Jajaho/LiPo-Board/src/kicad-2019/LiPo-BoardV1-2019.kicad_pcb

## KiCad design src/kicad-2019/LiPo-BoardV1-2019.kicad_pcb (2026-10-23)

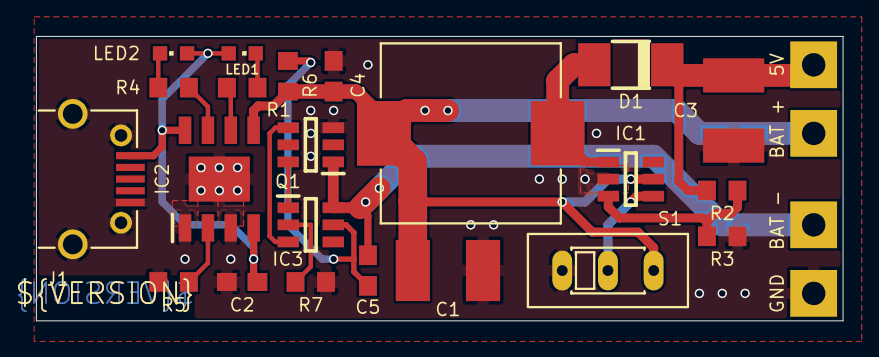
[picture p1: board LiPo-BoardV1-2019.kicad_pcb from above]

Board: 2 copper layers, 44.8 x 15.8 mm, 26 parts (0 on the bottom side), 17 nets.

Parts:
C1, C3: 22uF; C1812
C2, C4: 10uF; C0603
C5: 100n; C0603
D1: SS34; DO-214AC
IC1: MT3608; SOT-23-6
IC2: TP4056; SOP-8
IC3: FS312F-G; SOT-23-6
J1: MICRO_USB; MICROUSB
J2: 5V; CON-PAD
J3: GND; CON-PAD
J4: BAT +; CON-PAD
J5: BAT -; CON-PAD
L1: SLO1040H220MTT; INDUCTOR10.8X10
LED1: GREEN; CHIPLED_0603
LED2: RED; CHIPLED_0603
Q1: FS8205; SOT-23-6
R1, R3, R4, R7: 1k; R0603
R2: 7k5; R0603
R5: 1k2; R0603
R6: 100R; R0603
S1: SPDT

Connections:
5V: C3.1, D1.C, J2.1, R2.2
BAT+: C1.1, C4.1, IC1.5, IC2.5, J4.1, L1.1, R6.1, S1.1
BAT-: C5.2, IC3.6, J5.1, Q1.1
GND: C1.2, C2.2, C3.2, C4.2, IC1.2, IC2.1, IC2.3, IC2.9, J1.5, J1.MP1, J1.MP2, J1.MP3, J1.MP4, J3.1, Q1.3, R3.1, R5.1, R7.1, S1.3
unnamed: D1.A, IC1.1, L1.2
unnamed: LED1.C, R1.2
unnamed: LED2.C, R4.2
unnamed: IC2.7, R4.1
unnamed: IC2.6, R1.1
unnamed: IC1.3, R2.1, R3.2
unnamed: IC2.2, R5.2
unnamed: IC1.4, S1.2
unnamed: IC3.1, Q1.6
unnamed: IC3.3, Q1.4
unnamed: IC3.2, R7.2
unnamed: C5.1, IC3.5, R6.2
VBUS: C2.1, IC2.4, IC2.8, J1.1, LED1.A, LED2.A
