Jajaho/LiPo-Board/src/LiPo-BoardV1.brd

## EAGLE design src/LiPo-BoardV1.brd (2023-07-04)

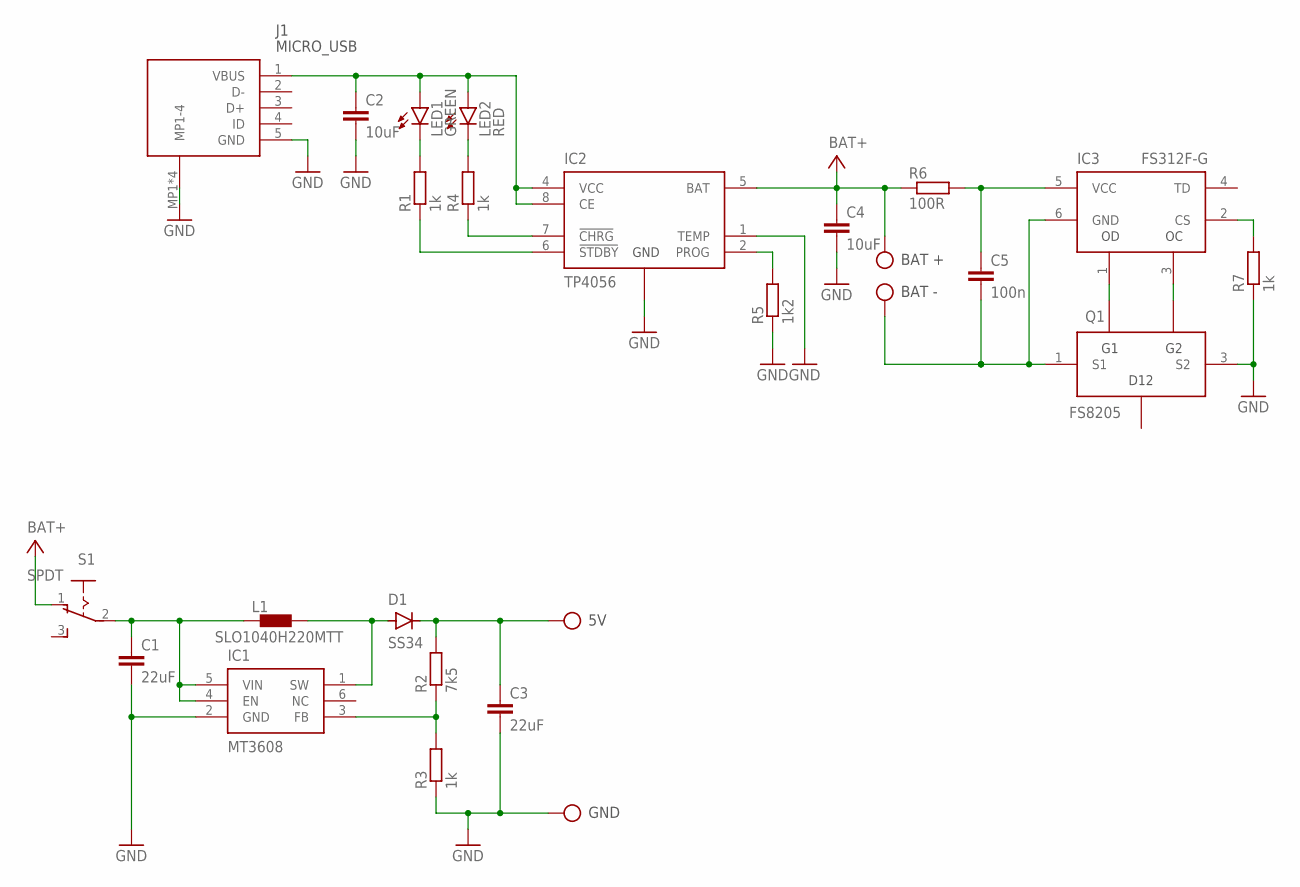
[picture p2: schematic LiPo-BoardV1.sch]

Parts:
C1, C3: 22uF; C1812
C2, C4: 10uF; C0603
C5: 100n; C0603
D1: SS34; DO-214AC
IC1: MT3608; SOT-23-6
IC2: TP4056; SOP-8
IC3: FS312F-G; SOT-23-6
J1: MICRO_USB; MICROUSB
J2: 5V; CON-PAD
J3: GND; CON-PAD
J4: BAT +; CON-PAD
J5: BAT -; CON-PAD
L1: SLO1040H220MTT; INDUCTOR10.8X10
LED1: GREEN; CHIPLED_0603
LED2: RED; CHIPLED_0603
Q1: FS8205; SOT-23-6
R1, R3, R4, R7: 1k; R0603
R2: 7k5; R0603
R5: 1k2; R0603
R6: 100R; R0603
S1: SPDT

Connections:
5V: C3.1, D1.C, J2.1, R2.2
BAT+: C4.1, IC2.5 (BAT), J4.1, R6.1, S1.1
BAT-: C5.2, IC3.6 (GND), J5.1, Q1.1 (S1)
GND: C1.2, C2.2, C3.2, C4.2, IC1.2 (GND), IC2.1 (TEMP), IC2.3 (GND), IC2.9 (GND), J1.5 (GND), J1.MP1 (MP1-4), J1.MP2 (MP1-4), J1.MP3 (MP1-4), J1.MP4 (MP1-4), J3.1, Q1.3 (S2), R3.1, R5.1, R7.1
unnamed: D1.A, IC1.1 (SW), L1.2
unnamed: LED1.C, R1.2
unnamed: LED2.C, R4.2
unnamed: IC2.7 (!CHRG), R4.1
unnamed: IC2.6 (!STDBY), R1.1
unnamed: IC1.3 (FB), R2.1, R3.2
unnamed: IC2.2 (PROG), R5.2
unnamed: IC3.1 (OD), Q1.6 (G1)
unnamed: IC3.3 (OC), Q1.4 (G2)
unnamed: IC3.2 (CS), R7.2
unnamed: C5.1, IC3.5 (VCC), R6.2
VBUS: C2.1, IC2.4 (VCC), IC2.8 (CE), J1.1 (VBUS), LED1.A, LED2.A
VIN: C1.1, IC1.4 (EN), IC1.5 (VIN), L1.1, S1.2

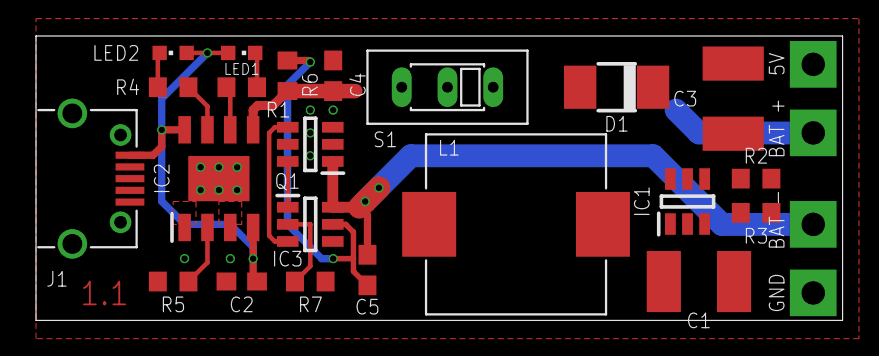
[picture p3: board LiPo-BoardV1.brd from above]

Board: 2 copper layers, 44.8 x 15.8 mm, 26 parts (0 on the bottom side), 17 nets.
