Jajaho/LiPo-Board/(commit log)

2023-07-04 Adds project
    [LiPo-BoardV1.brd, LiPo-BoardV1.sch]
2023-07-08 Add kicad project files, restructure folders
2023-07-08 Update kicad schematic
    make it prettier
2026-10-21 Remove KiCad backup folder from repo
    Stop tracking the auto-generated LiPo-BoardV1-backups archives and
    ignore KiCad *-backups/ and .history/ folders going forward.
2026-10-21 Add actions workflow for schematics generation
2026-10-23 Match the KiCad-2019 board to the 2019 Gerbers
    The EAGLE import had the wrong copper pour nets, a near-zero
    copper-to-edge clearance and solid pad connections. The pour now has
    EAGLE's thermal reliefs (0.255 mm gap, 0.5 mm spokes) and 0.2 mm board
    edge clearance, and its nets are fixed. Compared with the original
    Gerbers, the stored fill now differs mainly in the pour clearance to
    other nets (0.20 mm vs 0.13 mm) and the version text.
    The README notes this, and that a re-export of the EAGLE design from
    Fusion today has 0.25 mm spokes and chamfered clearance corners.
